Zinxiee/Rubikinators/Electrical Config Diagrams/pi_circuit_diagram.png

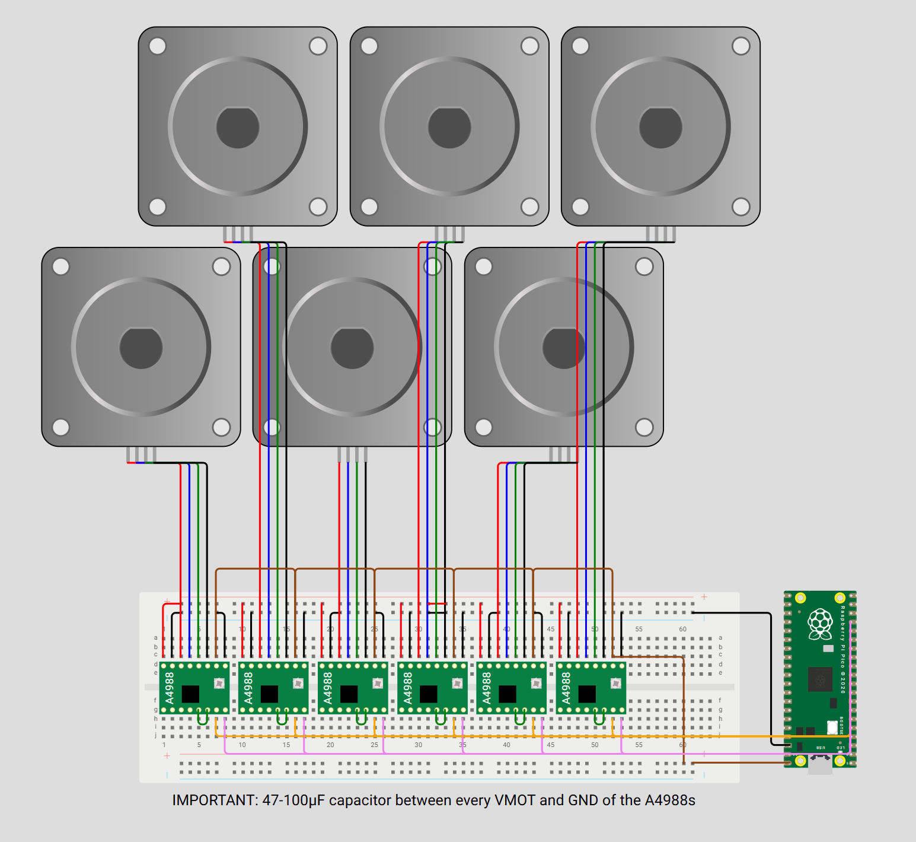
Electrical Config Diagrams/pi_circuit_diagram.png
