Zinxiee/Rubikinators/(commit log)

2026-06-15 Create motor circuit diagram for pi
2026-06-15 upload circuit diagram png
2026-06-15 Update NOTE.txt with clarification on Raspberry Pi usage
    Clarify that the Raspberry Pi Pico is a visual substitute and not the actual microcontroller used in the project.
2026-06-16 Add camera_lock.py for webcam configuration
    Initial implementation of camera lock functionality to configure Logitech C270 webcams with fixed exposure and white balance settings.
    [camera_lock.py]
2026-06-16 Add camera_lock import to cube_solver.py
2026-06-17 created motor test script
2026-06-17 Update color_test.py with camera_lock
2026-06-17 Update camera port from 1 to 2
